chrissavage2300/PIC-High-Powered-LED-Lamp/README.md

# PIC-High-Powered-LED-Lamp
A high power RGBW LED Lamp that uses 18650 batteries and a remote RF signal.
