chrissavage2300/PIC-High-Powered-LED-Lamp/BOM/BOM_RainbowLED_2022_12_28_A.ods

Part | Value | Device | Package | Description | Mouser PN
C1 | 390uF, 20SVPF390M | 20SVPF390M | CAP_20SVPF390M | Check availability | 667-20SVPF390M (https://www.mouser.com/ProductDetail/667-20SVPF390M) | $2.10
C2 | 680 pF | CAP0805 | 805 | Capacitor | GCJ219R72A681KA01D | $0.25
C3 | 15 nF | CAP0805 | 805 | Capacitor | 81-GRM21R72A153KA01L (https://www.mouser.com/ProductDetail/81-GRM21R72A153KA01L) | $0.08
C4 | 220uF, APXF6R3ARA221MF61G | CPOL-USUD-5X5,8 | UD-5X5,8_NICHICON | POLARIZED CAPACITOR, American symbol | 661-APXF6R3RA221MF61 (https://www.mouser.com/ProductDetail/661-APXF6R3RA221MF61) | $0.79
C5 | 100nF | CAP0805 | 805 | Capacitor | 81-GRM21BR72A104KA4K (https://www.mouser.com/ProductDetail/81-GRM21BR72A104KA4K)
C6 | 10pF | CAP0805 | 805 | Capacitor | 603-CC805JRNPO9BN100 (https://www.mouser.com/ProductDetail/603-CC805JRNPO9BN100) | $0.04
D1 | SS24-HF | DIODESMA-ALT | SMA-DIODE_ALT | Diode | stock | $0.25
D2 | JE2835_B_G | JE2835_B_G | JE2835_BLUE | Footprint for JE2835 BLUE or GREEN | 941-JE2835ABLN05AN 941-JE2835AGRN02AN 941-JE2835ARDN01AN 941-JE2835BWTH40GAN (https://www.mouser.com/ProductDetail/941-JE2835ABLN05AN) | $0.29
D3 | JE2835_B_G | JE2835_B_G | JE2835_BLUE | Footprint for JE2835 BLUE or GREEN | same | $0.29
D4 | JE2835_B_G | JE2835_B_G | JE2835_BLUE | Footprint for JE2835 BLUE or GREEN | same | $0.29
D5 | JE2835_B_G | JE2835_B_G | JE2835_BLUE | Footprint for JE2835 BLUE or GREEN | same | $0.29
D6 | JE2835_B_G | JE2835_B_G | JE2835_BLUE | Footprint for JE2835 BLUE or GREEN | same | $0.29
D7 | JE2835_B_G | JE2835_B_G | JE2835_BLUE | Footprint for JE2835 BLUE or GREEN | same | $0.29
D8 | JE2835_B_G | JE2835_B_G | JE2835_BLUE | Footprint for JE2835 BLUE or GREEN | same | $0.29
D9 | JE2835_B_G | JE2835_B_G | JE2835_BLUE | Footprint for JE2835 BLUE or GREEN | same | $0.29
D10 | JE2835_B_G | JE2835_B_G | JE2835_BLUE | Footprint for JE2835 BLUE or GREEN | same | $0.29
D11 | JE2835_B_G | JE2835_B_G | JE2835_BLUE | Footprint for JE2835 BLUE or GREEN | same | $0.29
D12 | JE2835_B_G | JE2835_B_G | JE2835_BLUE | Footprint for JE2835 BLUE or GREEN | same | $0.29
D13 | JE2835_B_G | JE2835_B_G | JE2835_BLUE | Footprint for JE2835 BLUE or GREEN | same | $0.29
D14 | JE2835_B_G | JE2835_B_G | JE2835_BLUE | Footprint for JE2835 BLUE or GREEN | same | $0.29
D15 | JE2835_B_G | JE2835_B_G | JE2835_BLUE | Footprint for JE2835 BLUE or GREEN | same | $0.29
D16 | JE2835_B_G | JE2835_B_G | JE2835_BLUE | Footprint for JE2835 BLUE or GREEN | same | $0.29
D17 | JE2835_B_G | JE2835_B_G | JE2835_BLUE | Footprint for JE2835 BLUE or GREEN | same | $0.29
D18 | JE2835_B_G | JE2835_B_G | JE2835_BLUE | Footprint for JE2835 BLUE or GREEN | same | $0.29
D19 | JE2835_B_G | JE2835_B_G | JE2835_BLUE | Footprint for JE2835 BLUE or GREEN | same | $0.29
D20 | JE2835_B_G | JE2835_B_G | JE2835_BLUE | Footprint for JE2835 BLUE or GREEN | same | $0.29
D21 | JE2835_B_G | JE2835_B_G | JE2835_BLUE | Footprint for JE2835 BLUE or GREEN | same | $0.29
IC1 | PIC16F1575 | PIC16F1503-I/SL | SOIC14_SL |  | PIC16F17126-I/SL | $1.19
IC2 | NCR421ZX | NCR421ZX | SOT223 |  | 771-NCR420ZX (https://www.mouser.com/ProductDetail/771-NCR420ZX) | $0.49
IC3 | NCR421ZX | NCR421ZX | SOT223 |  | 771-NCR420ZX (https://www.mouser.com/ProductDetail/771-NCR420ZX) | $0.49
IC4 | NCR421ZX | NCR421ZX | SOT223 |  | 771-NCR420ZX (https://www.mouser.com/ProductDetail/771-NCR420ZX) | $0.49
IC5 | NCR421ZX | NCR421ZX | SOT223 |  | 771-NCR420ZX (https://www.mouser.com/ProductDetail/771-NCR420ZX) | $0.49
IC6 | NCR421ZX | NCR421ZX | SOT223 |  | 771-NCR420ZX (https://www.mouser.com/ProductDetail/771-NCR420ZX) | $0.49
IC7 | LM3478MA/NOPB | LM3478MA/NOPB | M08A |  | 926-LM3478MAX/NOPB (https://www.mouser.com/ProductDetail/926-LM3478MAX-NOPB) | $2.73
JP1 |  | M05LOCK | 1X05_LOCK | Header 5 | stock
JP2 | M02LOCK_LONGPADS | M02LOCK_LONGPADS | 1X02_LOCK_LONGPADS | Standard 2-pin 0.1 | stock
JP5 | M02LOCK | M02LOCK | 1X02_LOCK | Standard 2-pin 0.1 | stock
L1 | SRR1280-4R7Y | SRR1260-100M | IND_BOURNS_SRR1260 |  | 652-SRR1280-4R7Y | $1.29
Q1 | CSD17308Q3 | CSD17308Q3 | TRANS_CSD17308Q3 | Check availability | 595-CSD17308Q3 (https://www.mouser.com/ProductDetail/595-CSD17308Q3) | $1.00
R1 | 5.1 | RESISTOR1206 | 1206 | Resistor | RC1206FR-075R1L (https://www.mouser.com/ProductDetail/YAGEO/RC1206FR-075R1L) | $0.13
R2 | 5.1 | RESISTOR1206 | 1206 | Resistor | RC1206FR-075R1L (https://www.mouser.com/ProductDetail/YAGEO/RC1206FR-075R1L) | $0.13
R3 | 5.1 | RESISTOR1206 | 1206 | Resistor | RC1206FR-075R1L (https://www.mouser.com/ProductDetail/YAGEO/RC1206FR-075R1L) | $0.13
R4 | 5.1 | RESISTOR1206 | 1206 | Resistor | RC1206FR-075R1L (https://www.mouser.com/ProductDetail/YAGEO/RC1206FR-075R1L) | $0.13
R5 | 5.1 | RESISTOR1206 | 1206 | Resistor | RC1206FR-075R1L (https://www.mouser.com/ProductDetail/YAGEO/RC1206FR-075R1L) | $0.13
R6 | 12mOhm | RESISTOR0805-RES | 805 | Resistor | 71-WFC0805R0120FE66 (https://www.mouser.com/ProductDetail/71-WFC0805R0120FE66) | $0.29
R7 | 100 | RESISTOR0805-RES | 805 | Resistor | 603-AC0805FR-7W100RL (https://www.mouser.com/ProductDetail/603-AC0805FR-7W100RL) | $0.07
R8 | 26.7k | RESISTOR0805-RES | 805 | Resistor | RC0805FR-0726K7L (https://www.mouser.com/ProductDetail/YAGEO/RC0805FR-0726K7L?qs=sGAEpiMZZMvdGkrng054t8AJgcdMkx7xRSnpU5yS1Rk%3D) | $0.07
R9 | 6.65k | RESISTOR0805-RES | 805 | Resistor | RC0805FR-076K65L (https://www.mouser.com/ProductDetail/YAGEO/RC0805FR-076K65L?qs=sGAEpiMZZMvdGkrng054t8AJgcdMkx7xZsGTMqJ6kBU%3D) | $0.10
R10 | 9.53k | RESISTOR0805-RES | 805 | Resistor | RC0805FR-079K53L (https://www.mouser.com/ProductDetail/YAGEO/RC0805FR-079K53L) | $0.10
R11 | 976 | RESISTOR0805-RES | 805 | Resistor | RC0805FR-07976RL (https://www.mouser.com/ProductDetail/YAGEO/RC0805FR-07976RL?qs=sGAEpiMZZMvdGkrng054tzB9oPOc3T13uaiO4Rmyq9g%3D) | $0.10
R12 | 21k | RESISTOR0805-RES | 805 | Resistor | RT0805FRE0721KL (https://www.mouser.com/ProductDetail/YAGEO/RT0805FRE0721KL) | $0.10
R13 | 20k | RESISTOR0805-RES | 805 | Resistor | RT0805FRE0720KL (https://www.mouser.com/ProductDetail/YAGEO/RT0805FRE0720KL?qs=sGAEpiMZZMvdGkrng054t8AJgcdMkx7x8Mi6g3ypq4o%3D) | $0.10
U$1 | C2847244/YUANR4A | C2847244/YUANR4A | C2847244/R4A | Feng Niao RF C2847244 Yuan R4A small, red, rectangular module with built in antenna. With sleep pin. | stock
 |  |  |  |  |  | total
 |  |  |  |  |  | $19.55
