chrissavage2300/PIC-High-Powered-LED-Lamp/schematics/WBDesign51.pdf

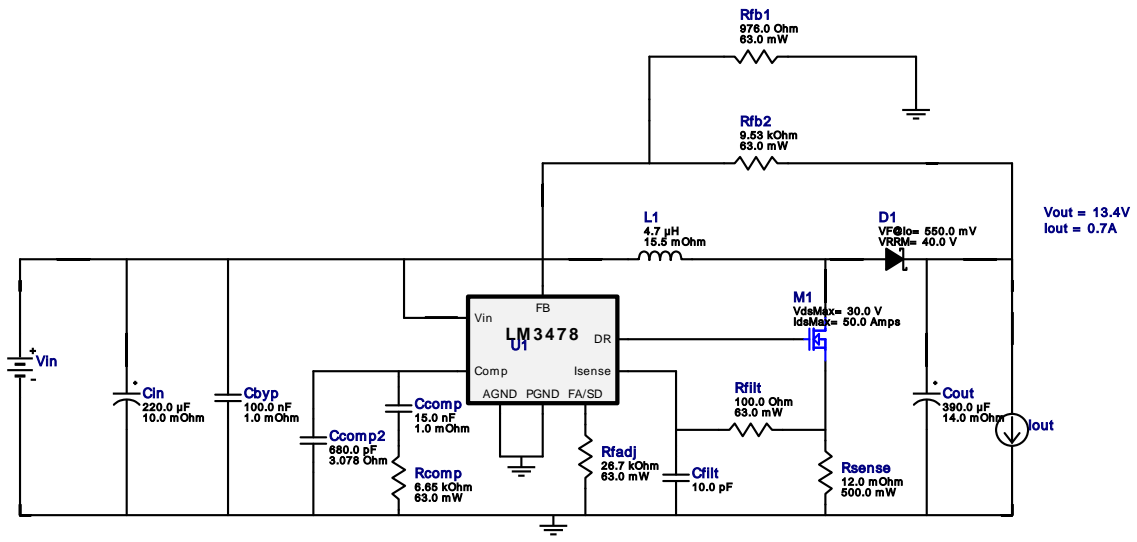
[picture p1: figure]
Rfadj 26.7 kOhm 63.0 m W; Com p; Isense; AGND PGND; Vin; Rcom p 6.65 kOhm 63.0 m W; Vout = 13.4V Iout = 0.7A D1 VF@Io= 550.0 m V VRRM= 40.0 V; Cin 220.0 µF 10.0 m Ohm; Cfilt 10.0 pF; Ccom p 15.0 nF 1.0 m Ohm; L1 4.7 µH 15.5 m Ohm; Rfilt 100.0 Ohm 63.0 m W; Ccom p2 680.0 pF 3.078 Ohm; Cout 390.0 µF 14.0 m Ohm; Cbyp 100.0 nF 1.0 m Ohm; M1 VdsMax= 30.0 V IdsMax= 50.0 Am ps; Rsense 12.0 m Ohm 500.0 m W; Rfb1 976.0 Ohm 63.0 m W; Rfb2 9.53 kOhm 63.0 m W; Iout

Copyright © 2022, Texas Instruments Incorporated | 1 | ti.com/webench

WEBENCH®
Design Report LM3478MM/NOPB : LM3478MM/NOPB 3V-4.2V to 13.40V @ 0.7A December 23, 2022 13:44:39 GMT-06:00

## WEBENCH ® Design Report

Design : 51 LM3478MM/NOPB
LM3478MM/NOPB 3V-4.2V to 13.40V @ 0.7A

VinMin = 3.0V
VinMax = 4.2V
Vout = 13.4V
Iout = 0.7A

Device = LM3478MM/NOPB
Topology = Boost
Created = 2022-12-23 13:14:08.065 BOM Cost = $3.55
BOM Count = 16
Total Pd = 1.43W
1. With the low turn of voltage of the LM34x8 your power supply may current limit before you reach your working input voltage. If this happens, or to preempt this from happening, you can include a low pass RC filter from input voltage to Vin on the IC. Make sure the rise time on the RC network is slower than your supply's rise time.

## Electrical BOM

Name | Manufacturer | Part Number | Properties | Qty Price | Footprint
Cbyp | MuRata | GRM155R70J104KA01D (http://search.murata.co.jp/Ceramy/PnsearchViewAction.do) Series= X7R | Cap= 100.0 nF ESR= 1.0 mOhm VDC= 6.3 V IRMS= 0.0 A
1 | $0.01
| | | | | 0402 3 mm²
Ccomp | MuRata | GRM155R71C153KA01D (http://search.murata.co.jp/Ceramy/PnsearchViewAction.do) Series= X7R

Cap= 15.0 nF
ESR= 1.0 mOhm
VDC= 16.0 V
IRMS= 0.0 A

1 $0.01
0402 3 mm²
Ccomp2 | TDK | CGA2B2X7R1H681K050BA (https://product.tdk.com/en/search/capacitor/ceramic/mlcc/info?part%5Fno%3DCGA2B2X7R1H681K050BA) Series= X7R

Cap= 680.0 pF
ESR= 3.0778 Ohm
VDC= 50.0 V
IRMS= 257.63 mA

1 $0.01
0402 3 mm²
Cfilt | Yageo | CC0805JRNPO9BN100 (http://www.yageo.com/documents/recent/UPY%2DGP%5FNP0%5F16V%2Dto%2D50V%5F10.pdf) Series= C0G/NP0

Cap= 10.0 pF
VDC= 50.0 V
IRMS= 0.0 A

1 $0.01
0805 7 mm²
Cin | Chemi-Con | APXF6R3ARA221MF61G (http://www.chemi%2Dcon.co.jp/cgi%2Dbin/CAT%5FDB/SEARCH/cat%5Fdb%5Fal.cgi?e%3De%26j%3Dp%26pdfname%3Dpxf) Series= PXF

Cap= 220.0 uF
ESR= 10.0 mOhm
VDC= 6.3 V
IRMS= 3.9 A

1 $0.26

CAPSMT_62_F61 74 mm²
Cout | Panasonic | 20SVPF390M Series= SVPF

Cap= 390.0 uF
ESR= 14.0 mOhm
VDC= 20.0 V
IRMS= 4.95 A

1 $1.11

CAPSMT_62_E12 106 mm²
D1 | Fairchild Semiconductor SS24FL | VF@Io= 550.0 mV VRRM= 40.0 V
1 | $0.09
SOD-123F 12 mm²

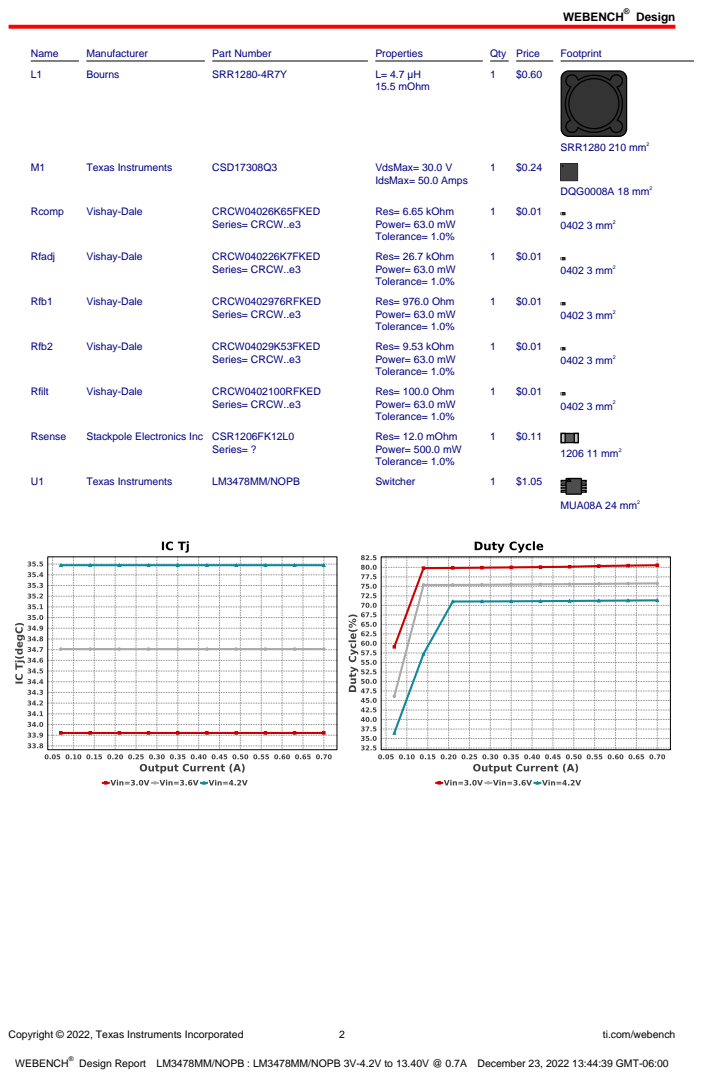
[picture p2: page 2]
Design; Copyright © 2022, Texas Instruments Incorporated; ti.com/webench; Name; Manufacturer; Part Number; Properties; Qty Price; Footprint; Bourns; SRR1280-4R7Y; 15.5 mOhm; SRR1280 210 mm²; Texas Instruments; CSD17308Q3; VdsMax= 30.0 V; IdsMax= 50.0 Amps; DQG0008A 18 mm²; Rcomp; Vishay-Dale; CRCW04026K65FKED; Series= CRCW..e3; Res= 6.65 kOhm Power= 63.0 mW Tolerance= 1.0%; 0402 3 mm²; Rfadj; CRCW040226K7FKED; Res= 26.7 kOhm Power= 63.0 mW Tolerance= 1.0%; Rfb1; CRCW0402976RFKED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

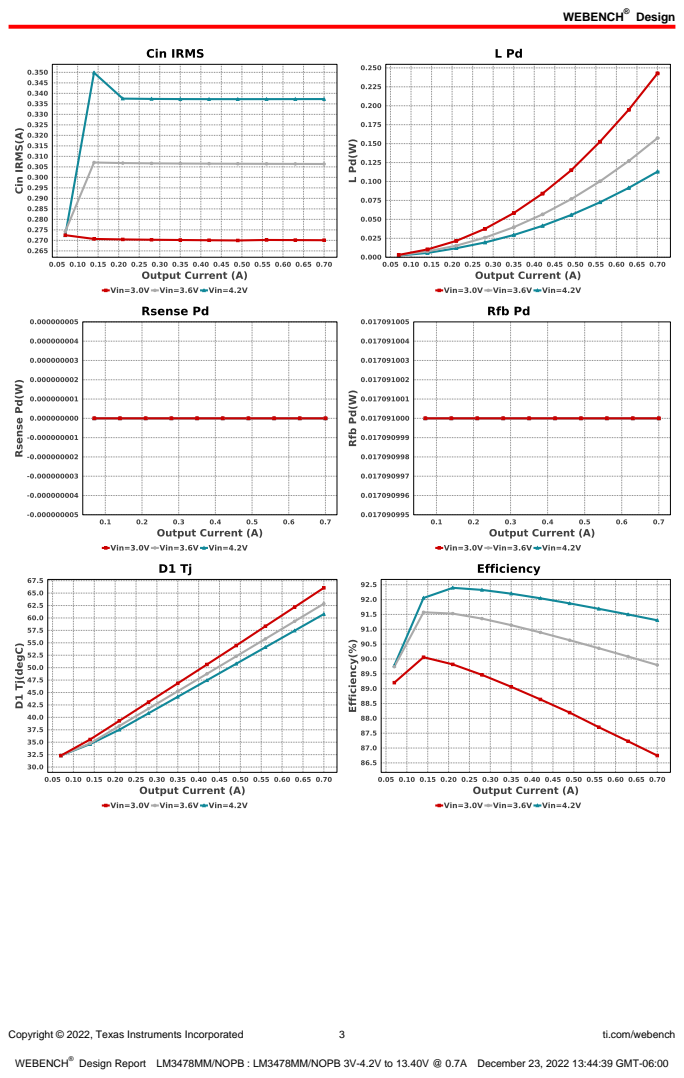
[picture p3: page 3]
Copyright © 2022, Texas Instruments Incorporated; ti.com/webench

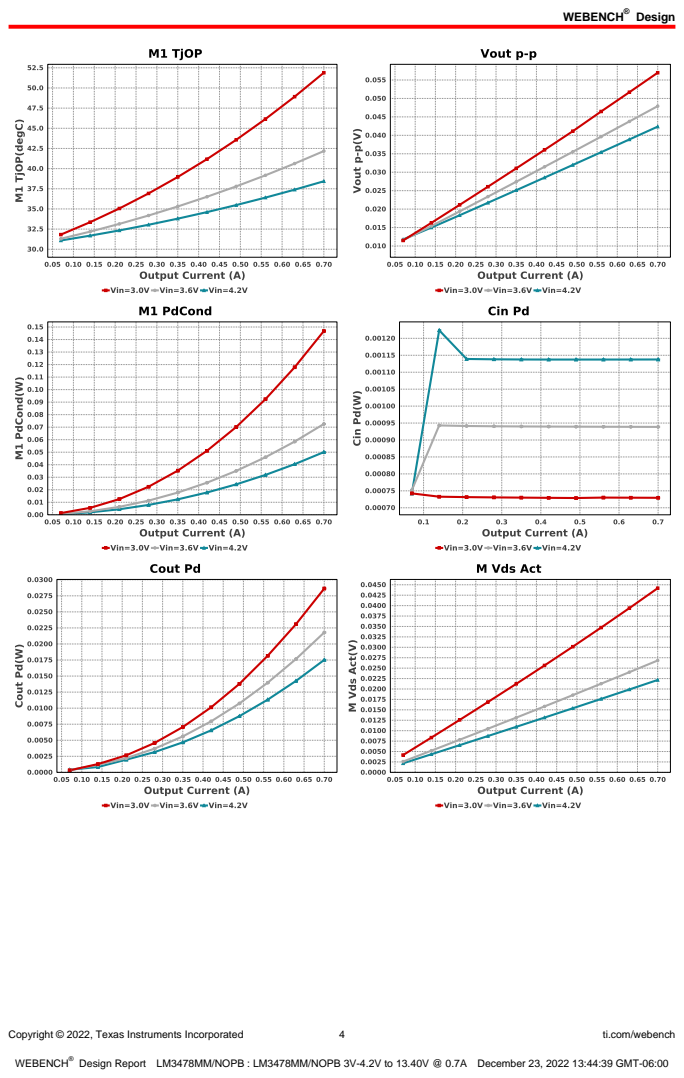
[picture p4: page 4]
Copyright © 2022, Texas Instruments Incorporated; ti.com/webench

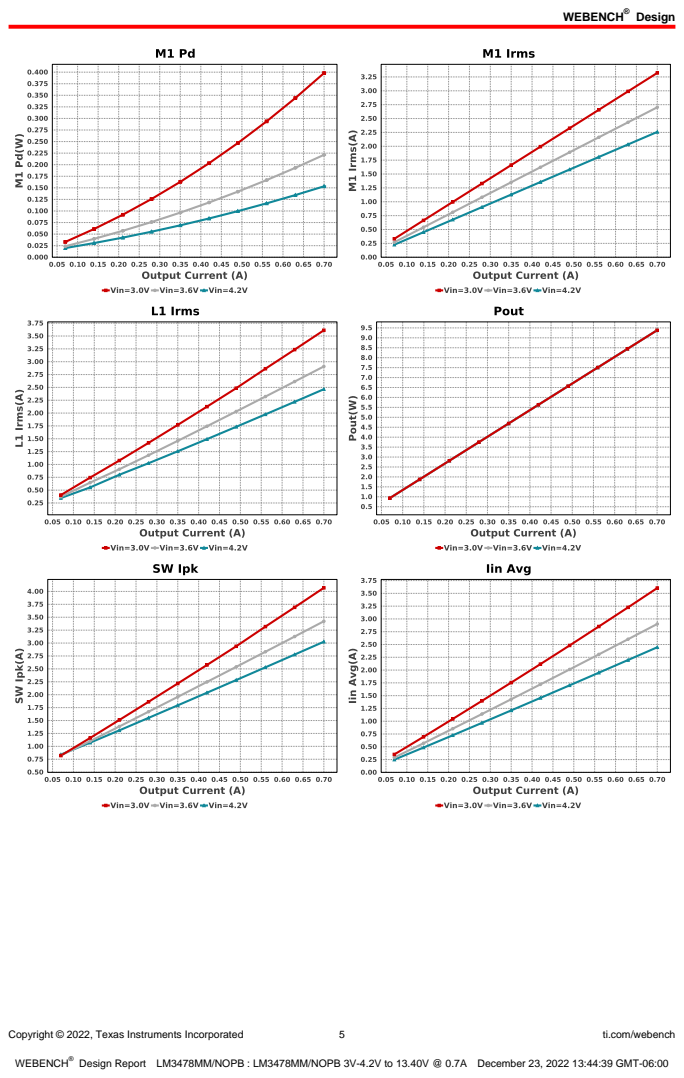
[picture p5: page 5]
Copyright © 2022, Texas Instruments Incorporated; ti.com/webench

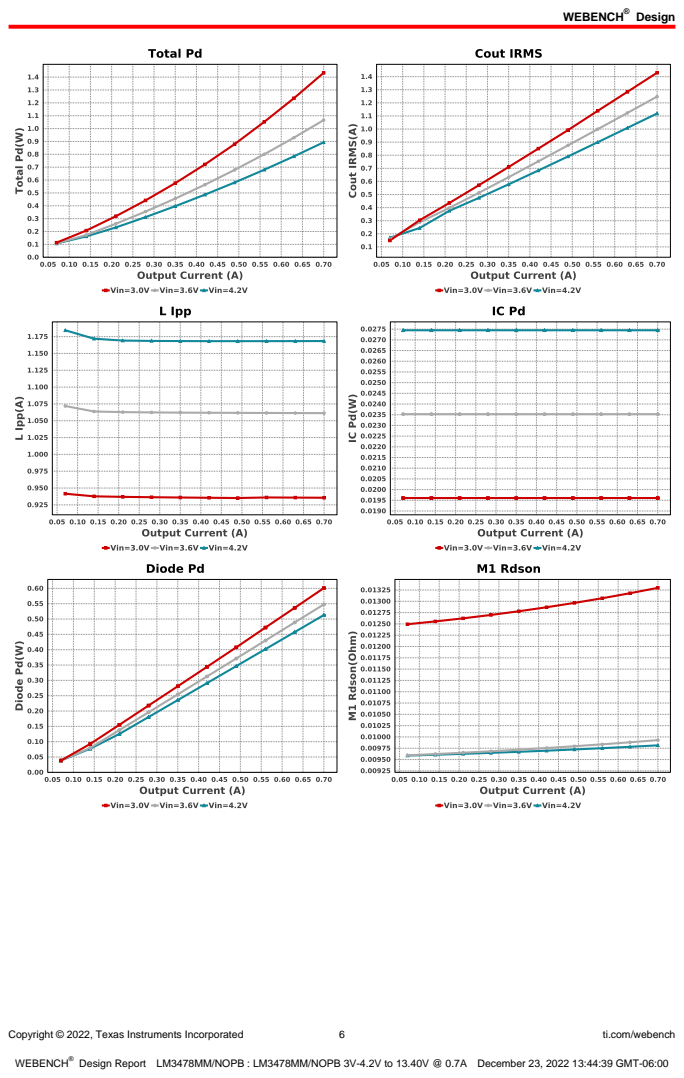
[picture p6: page 6]
Copyright © 2022, Texas Instruments Incorporated; ti.com/webench

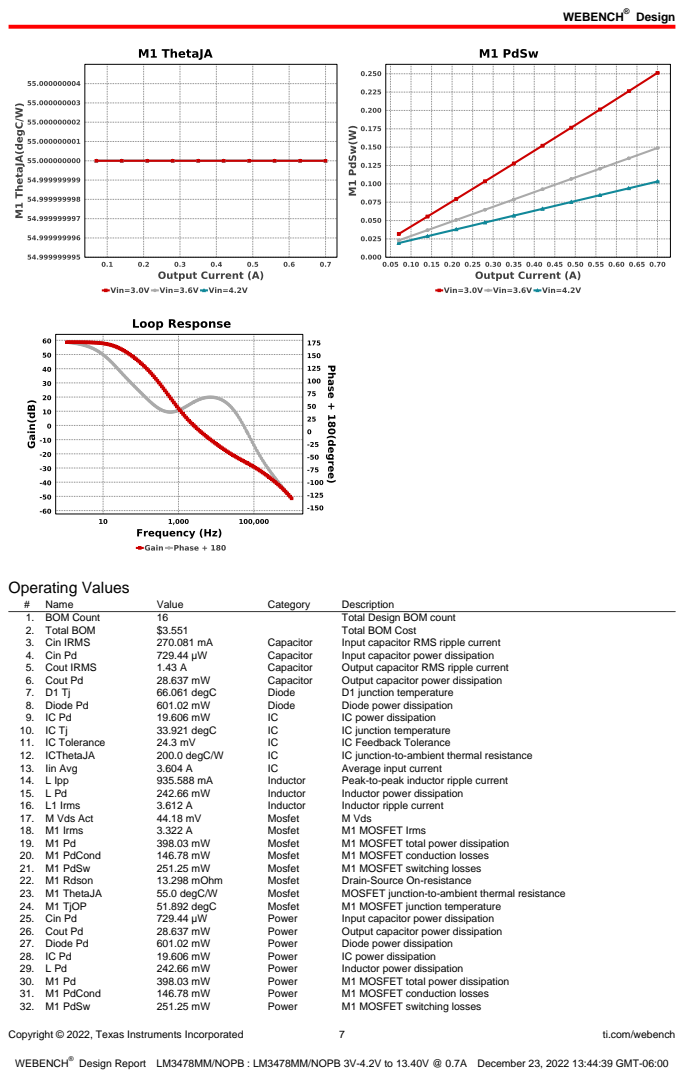
[picture p7: page 7]
Copyright © 2022, Texas Instruments Incorporated; ti.com/webench; Operating Values; Name; Value; Category; Description; 1. BOM Count; Total Design BOM count; 2. Total BOM; Total BOM Cost; 3. Cin IRMS; Capacitor; Input capacitor RMS ripple current; 4. Cin Pd; Input capacitor power dissipation; 5. Cout IRMS; Output capacitor RMS ripple current; 6. Cout Pd; Output capacitor power dissipation; 66.061 degC; Diode; D1 junction temperature; 8. Diode Pd; Diode power dissipation; IC power dissipation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

Copyright © 2022, Texas Instruments Incorporated | 8 | ti.com/webench
# | Name | Value | Category | Description

33. Rfb Pd | 17.091 mW | Power | Rfb Power Dissipation
34. Rsense Pd | 0.0 W | Power | LED Current Rsns Power Dissipation
35. Total Pd | 1.433 W | Power | Total Power Dissipation
36. Rfb Pd | 17.091 mW | Resistor | Rfb Power Dissipation
37. Rsense Pd | 0.0 W | Resistor | LED Current Rsns Power Dissipation
38. Cross Freq | 1.902 kHz | System
| | | Information | Bode plot crossover frequency
39. Duty Cycle | 80.566 % | System
| | | Information | Duty cycle
40. Efficiency | 86.746 % | System
| | | Information | Steady state efficiency
41. FootPrint | 486.0 mm² | System
| | | Information | Total Foot Print Area of BOM components
42. Frequency | 541.734 kHz | System
| | | Information | Switching frequency
43. Gain Marg | -23.314 dB | System
| | | Information | Bode Plot Gain Margin
44. Iout | 700.0 mA | System
| | | Information | Iout operating point
45. Low Freq Gain | 55.302 dB | System
| | | Information | Gain at 1Hz
46. Mode | CCM | System
| | | Information | Conduction Mode
47. Phase Marg | 51.26 deg | System
| | | Information | Bode Plot Phase Margin
48. Pout | 9.38 W | System
| | | Information | Total output power
49. SW Ipk | 4.07 A | System
| | | Information | Peak switch current
50. Vin | 3.0 V | System
| | | Information | Vin operating point
51. Vout | 13.4 V | System
| | | Information | Operational Output Voltage
52. Vout Actual | 13.563 V | System
| | | Information | Vout Actual calculated based on selected voltage divider resistors
53. Vout Tolerance | 3.796 % | System
| | | Information | Vout Tolerance based on IC Tolerance (no load) and voltage divider resistors if applicable
54. Vout p-p | 56.975 mV | System
| | | Information | Peak-to-peak output ripple voltage

## Design Inputs

Name | Value | Description
| Iout | | 700.0 m | Maximum Output Current
VinMax | 4.2 | Maximum input voltage
VinMin | 3.0 | Minimum input voltage
Vout | 13.4 | Output Voltage
| base_pn | | LM3478 | Base Product Number
source | DC | Input Source Type
Ta | 30.0 | Ambient temperature


Copyright © 2022, Texas Instruments Incorporated | 9 | ti.com/webench

## Assembly

## Component Testing

Some published data on components in datasheets such as Capacitor ESR and Inductor DC resistance is based on conservative values that will guarantee that the components always exceed the specification. For design purposes it is usually better to work with typical values. Since this data is not always available it is a good practice to measure the Capacitance and ESR values of Cin and Cout, and the inductance and DC resistance of L1 before assembly of the board. Any large discrepancies in values should be electrically simulated in WEBENCH to check for instabilities and thermally simulated in WebTHERM to make sure critical temperatures are not exceeded.

## Soldering Component to Board

If board assembly is done in house it is best to tack down one terminal of a component on the board then solder the other terminal. For surface mount parts with large tabs, such as the DPAK, the tab on the back of the package should be pre-tinned with solder, then tacked into place by one of the pins. To solder the tab town to the board place the iron down on the board while resting against the tab, heating both surfaces simultaneously. Apply light pressure to the top of the plastic case until the solder flows around the part and the part is flush with the PCB. If the solder is not flowing around the board you may need a higher wattage iron (generally 25W to 30W is enough).

## Initial Startup of Circuit

It is best to initially power up the board by setting the input supply voltage to the lowest operating input voltage 3.0V and set the input supply's current limit to zero. With the input supply off connect up the input supply to Vin and GND. Connect a digital volt meter and a load if needed to set the minimum Iout of the design from Vout and GND. Turn on the input supply and slowly turn up the current limit on the input supply. If the voltage starts to rise on the input supply continue increasing the input supply current limit while watching the output voltage. If the current increases on the input supply, but the voltage remains near zero, then there may be a short or a component misplaced on the board. Power down the board and visually inspect for solder bridges and recheck the diode and capacitor polarities. Once the power supply circuit is operational then more extensive testing may include full load testing, transient load and line tests to compare with simulation results.

## Load Testing

The setup is the same as the initial startup, except that an additional digital voltmeter is connected between Vin and GND, a load is connected between Vout and GND and a current meter is connected in series between Vout and the load. The load must be able to handle at least rated output power + 50% ( 7.5 watts for this design). Ideally the load is supplied in the form of a variable load test unit. It can also be done in the form of suitably large power resistors. When using an oscilloscope to measure waveforms on the prototype board, the ground leads of the oscilloscope probes should be as short as possible and the area of the loop formed by the ground lead should be kept to a minimum. This will help reduce ground lead inductance and eliminate EMI noise that is not actually present in the circuit.

## Design Assistance

1. Master key : 1955E47119554D04[v1]
2. LM3478 Product Folder : http://www.ti.com/product/LM3478 : contains the data sheet and other resources.

Copyright © 2022, Texas Instruments Incorporated | 10 | ti.com/webench

Important Notice and Disclaimer

TI provides technical and reliability data (including datasheets), design resources (including reference designs), application or other design advice, web tools, safety information, and other resources AS IS and with all faults, and disclaims all warranties. These resources are intended for skilled developers designing with TI products. You are solely responsible for (1) selecting the appropriate TI products for your application, (2) designing, validating and testing your application, and (3) ensuring your application meets applicable standards, and any other safety, security, or other requirements.

These resources are subject to change without notice. TI grants you permission to use these resources only for development of an application that uses the TI products described in the resource. Other reproduction and display of these resources is prohibited. No license is granted to any other TI intellectual property right or to any third party intellectual property right. TI disclaims responsibility for, and you will fully indemnify TI and its representatives against, any claims, damages, costs, losses, and liabilities arising out of your use of these resources.

Providing these resources does not expand or otherwise alter TI's applicable Terms of Sale or other applicable terms available either on ti.com or provided in conjunction with TI products.
