chrissavage2300/PIC-High-Powered-LED-Lamp/schematics/HP_LED_2023_01_22_A.pdf

# DR 6 FA/SD

# Q1 R⁶

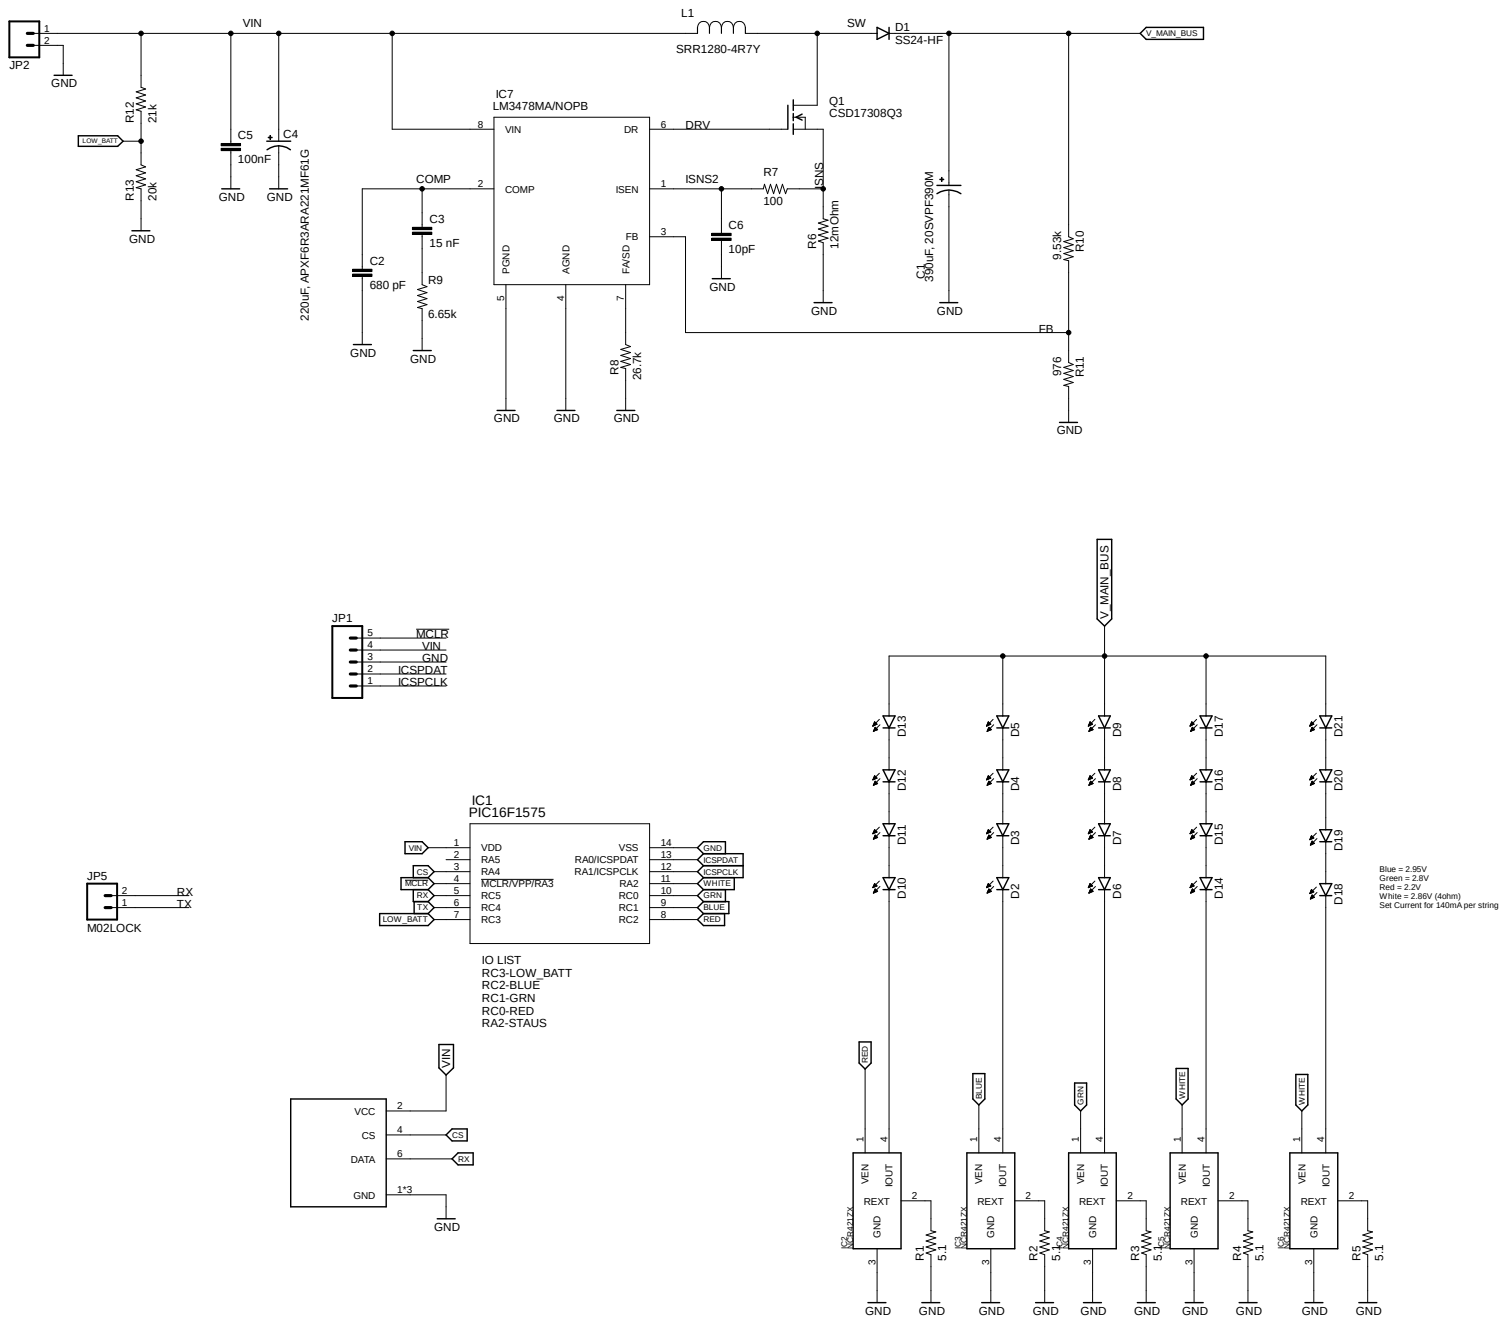
[picture p9: page 1]
