chrissavage2300/PIC-High-Powered-LED-Lamp/schematics/LED_Transmitter_2023_01_22_A.brd

## EAGLE design schematics/LED_Transmitter_2023_01_22_A.brd (2023-01-22)

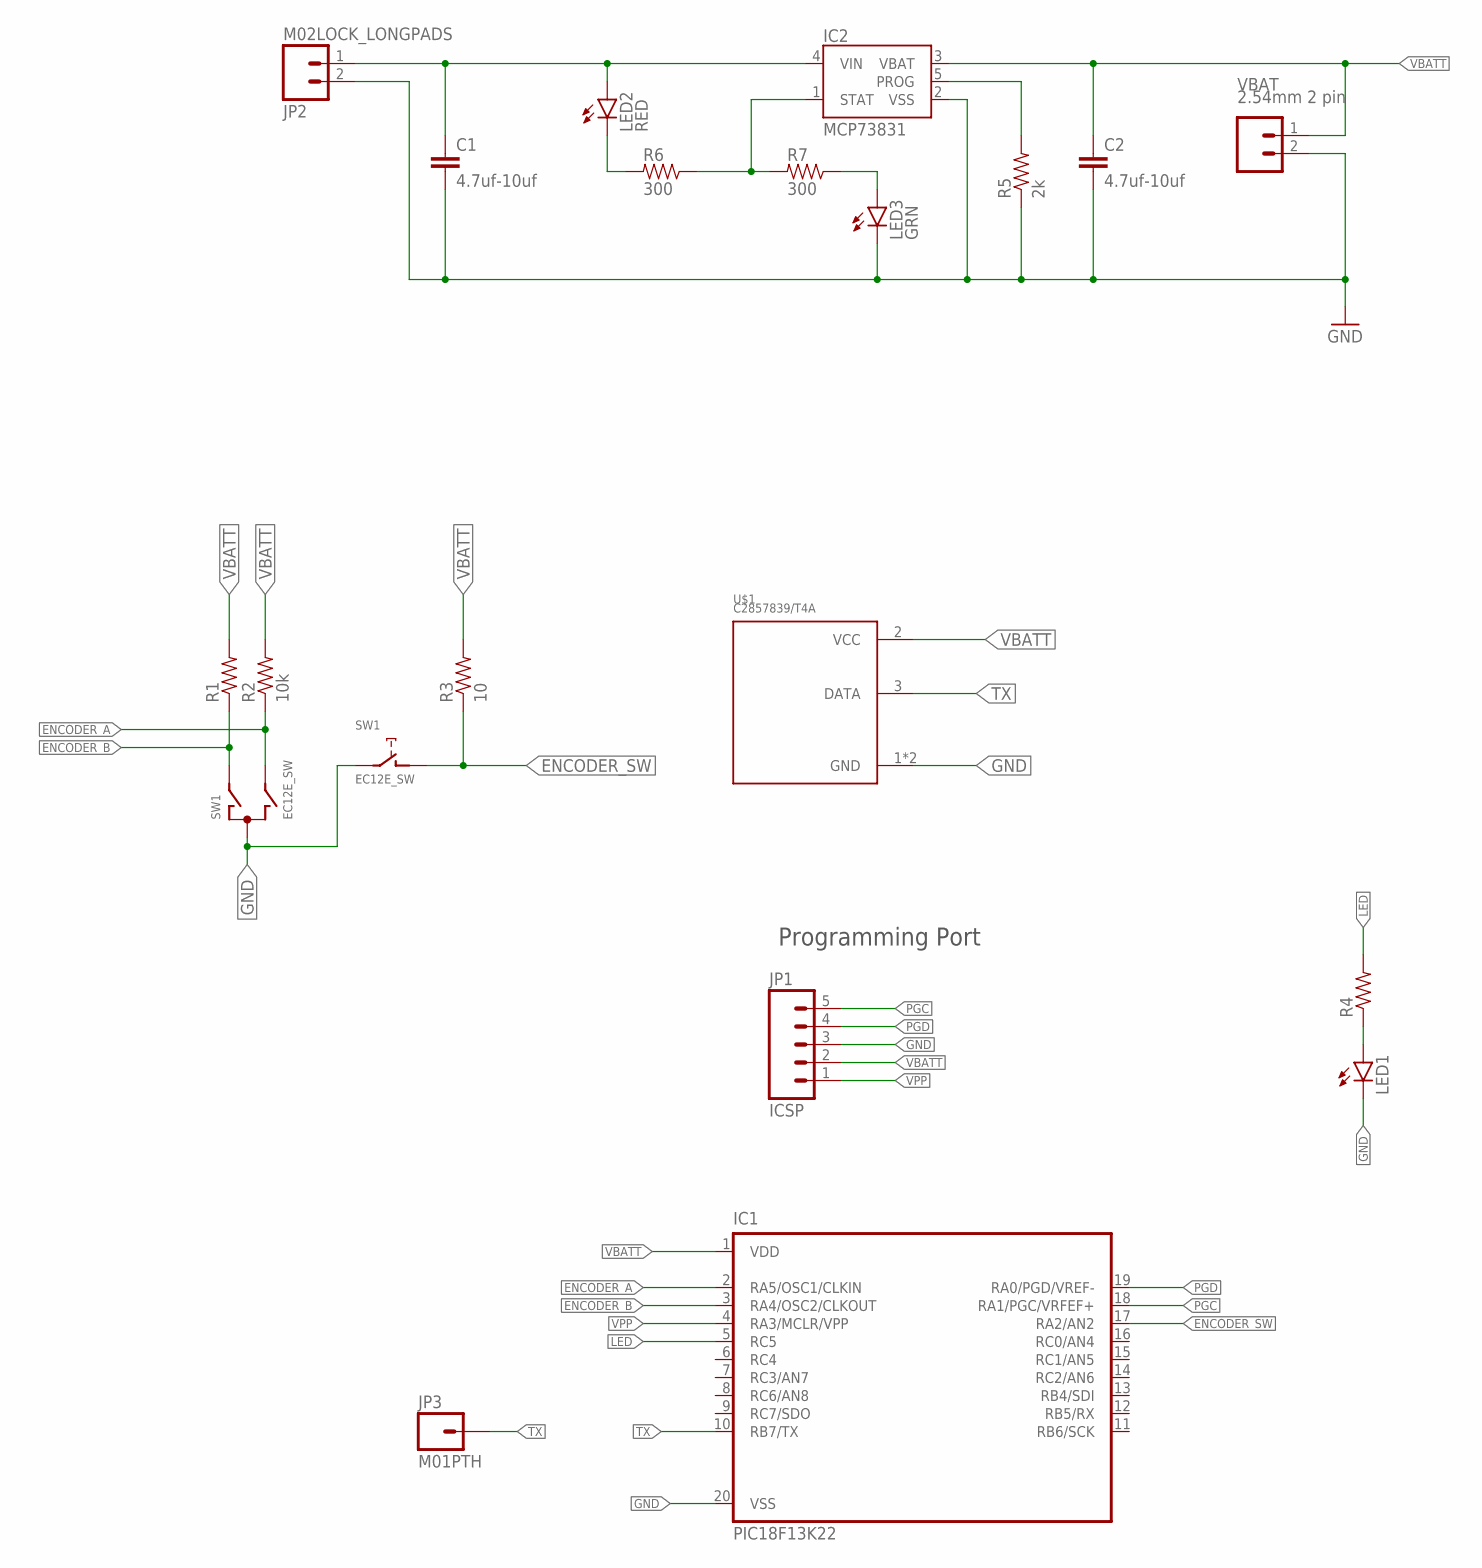
[picture p10: schematic LED_Transmitter_2023_01_22_A.sch]

Parts:
C1, C2: 4.7uf-10uf; 1206
IC1: PIC18F13K22; DIL20
IC2: MCP73831; SOT23-5
JP1: ICSP; 1X05
JP2: M02LOCK_LONGPADS; 1X02_LOCK_LONGPADS
JP3: M01PTH; 1X01
LED1: LED1206; LED-1206
LED2: RED; LED-1206
LED3: GRN; LED-1206
R1, R4: RESISTOR1206; 1206
R2: 10k; 1206
R3: 10; 1206
R5: 2k; 1206
R6, R7: 300; 1206
SW1: EC12E_SW; ALPS_EC12E_SW
U$1: C2857839/T4A; 1X04_LOCK_LONGPADS
VBAT: 2.54mm 2 pin; JST-2-PTH-VERT

Connections:
ENCODER_A: IC1.2 (RA5/OSC1/CLKIN), R2.1, SW1.B
ENCODER_B: IC1.3 (RA4/OSC2/CLKOUT), R1.1, SW1.A
ENCODER_SW: IC1.17 (RA2/AN2), R3.1, SW1.D (1)
GND: C1.2, C2.2, IC1.20 (VSS), IC2.2 (VSS), JP1.3, JP2.2, LED1.C, LED3.C, R5.1, SW1.C, SW1.E (2), U$1.1 (GND), U$1.4 (GND), VBAT.2
LED: IC1.5 (RC5), R4.2
unnamed: LED1.A, R4.1
unnamed: LED2.C, R6.2
unnamed: IC2.1 (STAT), R6.1, R7.2
unnamed: IC2.5 (PROG), R5.2
unnamed: LED3.A, R7.1
PGC: IC1.18 (RA1/PGC/VRFEF+), JP1.5
PGD: IC1.19 (RA0/PGD/VREF-), JP1.4
TX: IC1.10 (RB7/TX), JP3.1, U$1.3 (DATA)
VBATT: C2.1, IC1.1 (VDD), IC2.3 (VBAT), JP1.2, R1.2, R2.2, R3.2, U$1.2 (VCC), VBAT.1
VBUS: C1.1, IC2.4 (VIN), JP2.1, LED2.A
VPP: IC1.4 (RA3/MCLR/VPP), JP1.1

Notes on the sheet:
Programming Port

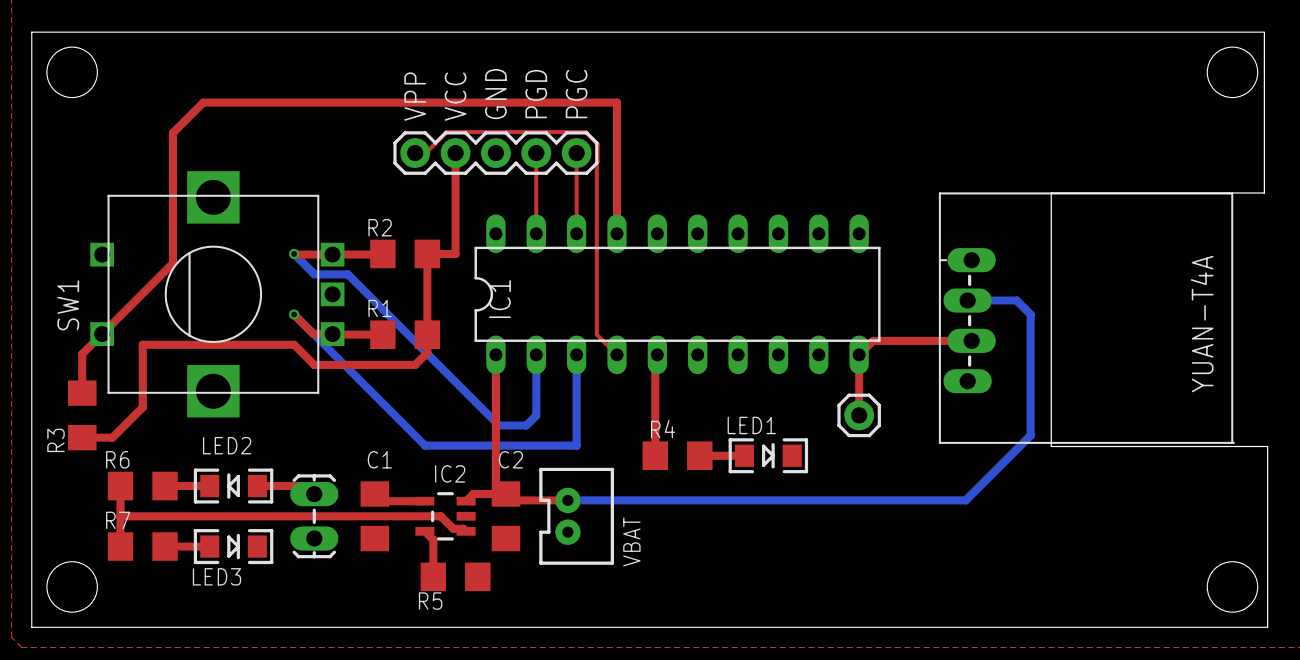
[picture p11: board LED_Transmitter_2023_01_22_A.brd from above]

Board: 2 copper layers, 77.8 x 37.5 mm, 20 parts (0 on the bottom side), 16 nets.
