chrissavage2300/PIC-High-Powered-LED-Lamp/schematics/PIC_HP_LED_2023_01_22_A.brd

## EAGLE design schematics/PIC_HP_LED_2023_01_22_A.brd (2023-01-22)

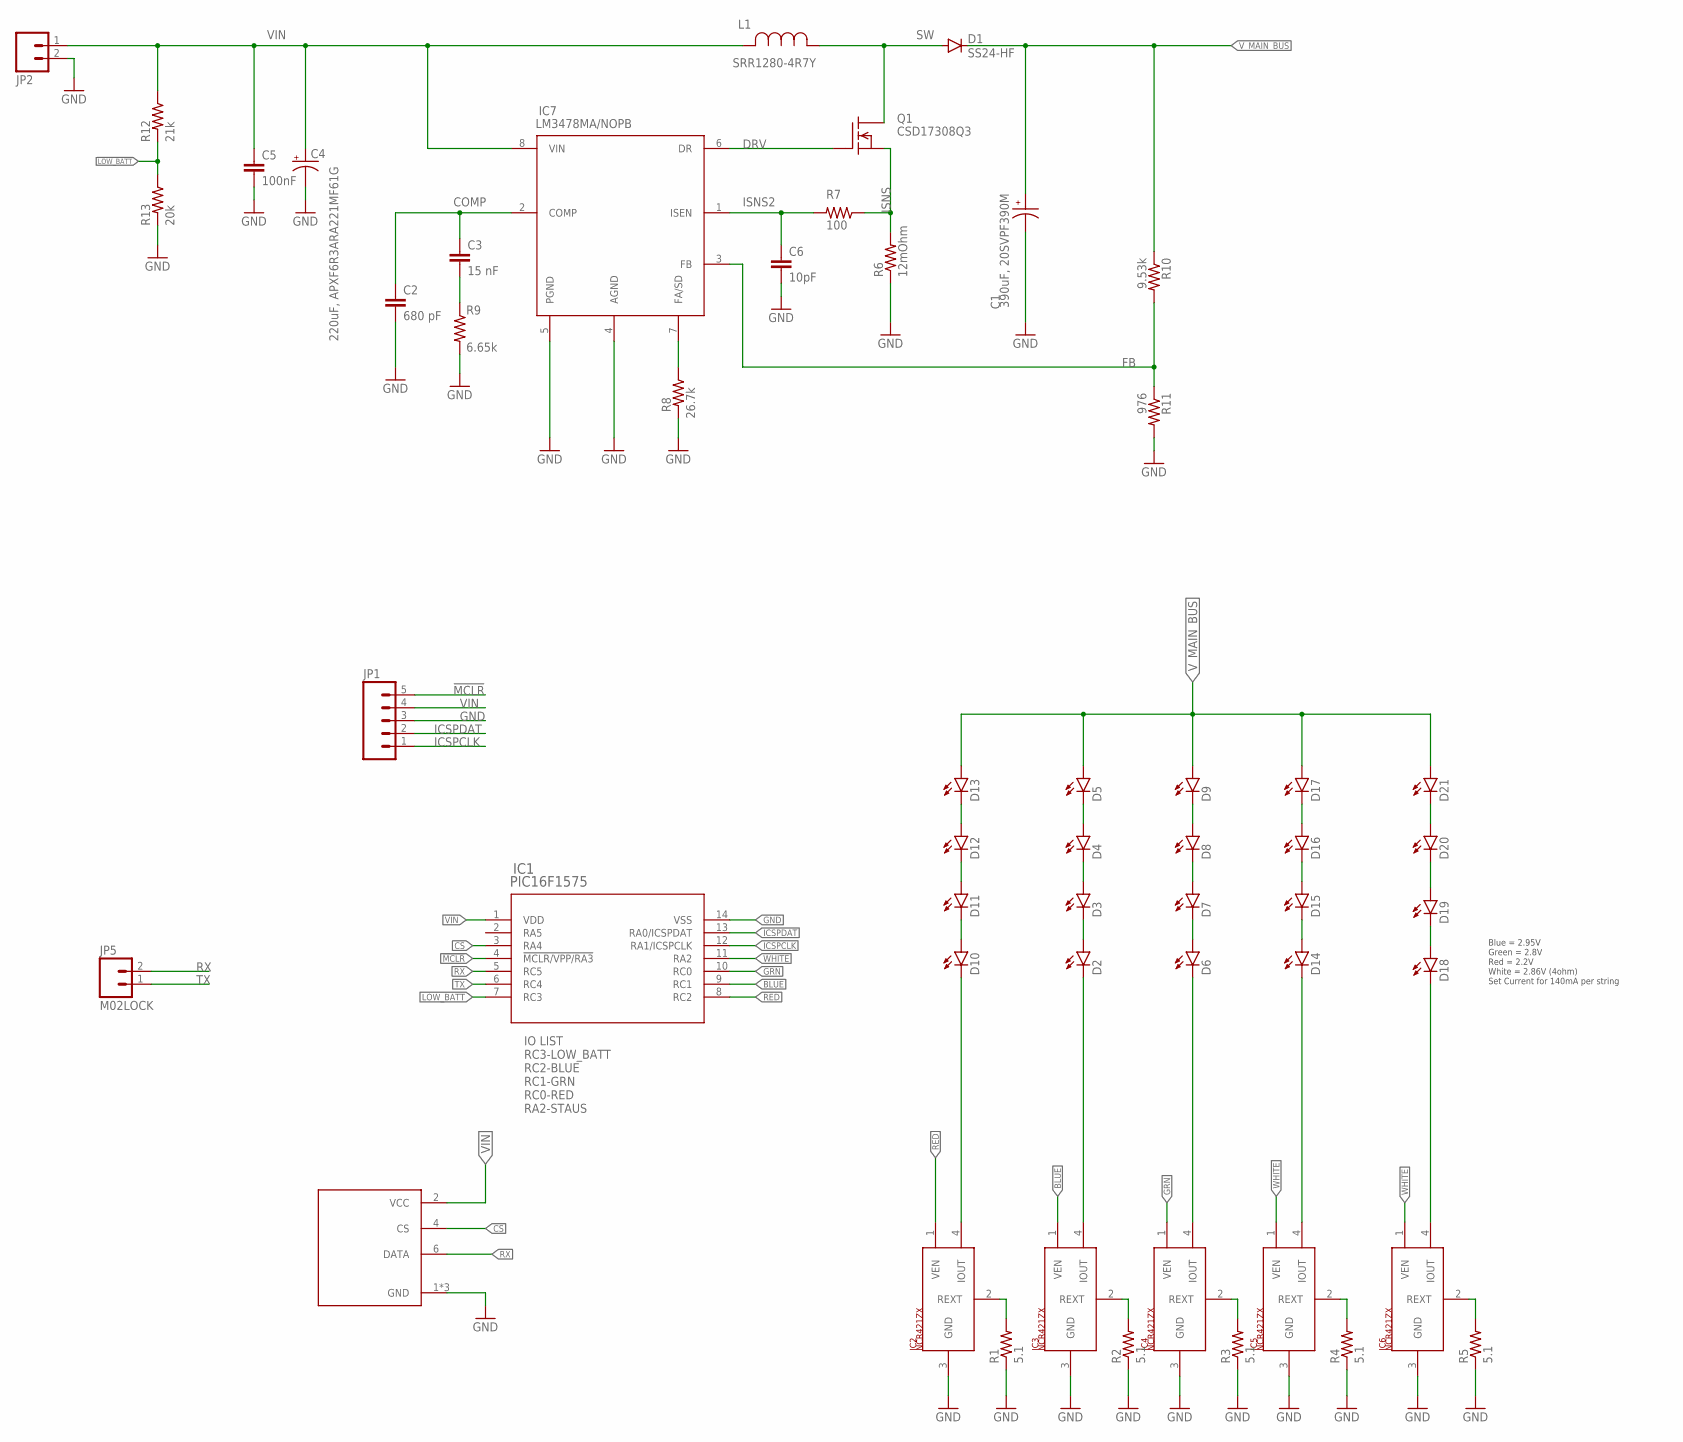
[picture p12: schematic PIC_HP_LED_2023_01_22_A.sch]

Parts:
C1: 390uF, 20SVPF390M; CAP_20SVPF390M
C2: 680 pF; 0805
C3: 15 nF; 0805
C4: 220uF, APXF6R3ARA221MF61G; UD-5X5,8_NICHICON
C5: 100nF; 0805
C6: 10pF; 0805
D1: SS24-HF; SMA-DIODE_ALT
D2, D3, D4, D5, D6, D7, D8, D9, D10, D11, D12, D13, D14, D15, D16, D17, D18, D19, D20, D21: JE2835_B_G; JE2835_BLUE
IC1: PIC16F1575; SOIC14_SL
IC2, IC3, IC4, IC5, IC6: NCR421ZX; SOT223
IC7: LM3478MA/NOPB; M08A
JP1: M05LOCK; 1X05_LOCK
JP2: M02LOCK_LONGPADS; 1X02_LOCK_LONGPADS
JP5: M02LOCK; 1X02_LOCK
L1: SRR1280-4R7Y; IND_BOURNS_SRR1260
Q1: CSD17308Q3; TRANS_CSD17308Q3
R1, R2, R3, R4, R5: 5.1; 1206
R6: 12mOhm; 0805
R7: 100; 0805
R8: 26.7k; 0805
R9: 6.65k; 0805
R10: 9.53k; 0805
R11: 976; 0805
R12: 21k; 0805
R13: 20k; 0805
U$1: C2847244/YUANR4A; C2847244/R4A

Connections:
!MCLR: IC1.4 (!MCLR/VPP/RA3), JP1.5
BLUE: IC1.9 (RC1), IC3.1 (VEN)
BLUE-: D2.C, IC3.4 (IOUT)
COMP: C2.1, C3.1, IC7.2 (COMP)
CS: IC1.3 (RA4), U$1.4 (CS)
DRV: IC7.6 (DR), Q1.G
FB: IC7.3 (FB), R10.2, R11.1
GND: C1.2, C2.2, C4.-, C5.2, C6.2, IC1.14 (VSS), IC2.3 (GND), IC3.3 (GND), IC4.3 (GND), IC5.3 (GND), IC6.3 (GND), IC7.4 (AGND), IC7.5 (PGND), JP1.3, JP2.2, R1.1, R2.1, R3.1, R4.1, R5.1, R6.1, R8.2, R9.2, R11.2, R13.2, U$1.1 (GND), U$1.3 (GND), U$1.5 (GND)
GRN: IC1.10 (RC0), IC4.1 (VEN)
GRN-: D6.C, IC4.4 (IOUT)
ICSPCLK: IC1.12 (RA1/ICSPCLK), JP1.1
ICSPDAT: IC1.13 (RA0/ICSPDAT), JP1.2
ISNS: Q1.S1 (S), Q1.S2 (S), Q1.S3 (S), R6.2, R7.1
ISNS2: C6.1, IC7.1 (ISEN), R7.2
LOW_BATT: IC1.7 (RC3), R12.2, R13.1
unnamed: D10.A, D11.C
unnamed: D6.A, D7.C
unnamed: D2.A, D3.C
unnamed: D3.A, D4.C
unnamed: D7.A, D8.C
unnamed: D11.A, D12.C
unnamed: D12.A, D13.C
unnamed: D8.A, D9.C
unnamed: D4.A, D5.C
unnamed: IC2.2 (REXT), R1.2
unnamed: IC3.2 (REXT), R2.2
unnamed: IC4.2 (REXT), R3.2
unnamed: IC5.2 (REXT), R4.2
unnamed: D14.A, D15.C
unnamed: D15.A, D16.C
unnamed: D16.A, D17.C
unnamed: D14.C, IC5.4 (IOUT)
unnamed: D18.A, D19.C
unnamed: D19.A, D20.C
unnamed: D20.A, D21.C
unnamed: D18.C, IC6.4 (IOUT)
unnamed: IC6.2 (REXT), R5.2
unnamed: IC7.7 (FA/SD), R8.1
unnamed: C3.2, R9.1
RED: IC1.8 (RC2), IC2.1 (VEN)
RED-: D10.C, IC2.4 (IOUT)
RX: IC1.5 (RC5), JP5.2, U$1.6 (DATA)
SW: D1.A, L1.1, Q1.5-8 (D)
TX: IC1.6 (RC4), JP5.1
VIN: C4.+, C5.1, IC1.1 (VDD), IC7.8 (VIN), JP1.4, JP2.1, L1.2, R12.1, U$1.2 (VCC)
V_MAIN_BUS: C1.1, D1.C, D5.A, D9.A, D13.A, D17.A, D21.A, R10.1
WHITE: IC1.11 (RA2), IC5.1 (VEN), IC6.1 (VEN)

Notes on the sheet:
IO LIST RC3-LOW_BATT RC2-BLUE RC1-GRN RC0-RED RA2-STAUS
Blue = 2.95V Green = 2.8V Red = 2.2V White = 2.86V (4ohm) Set Current for 140mA per string

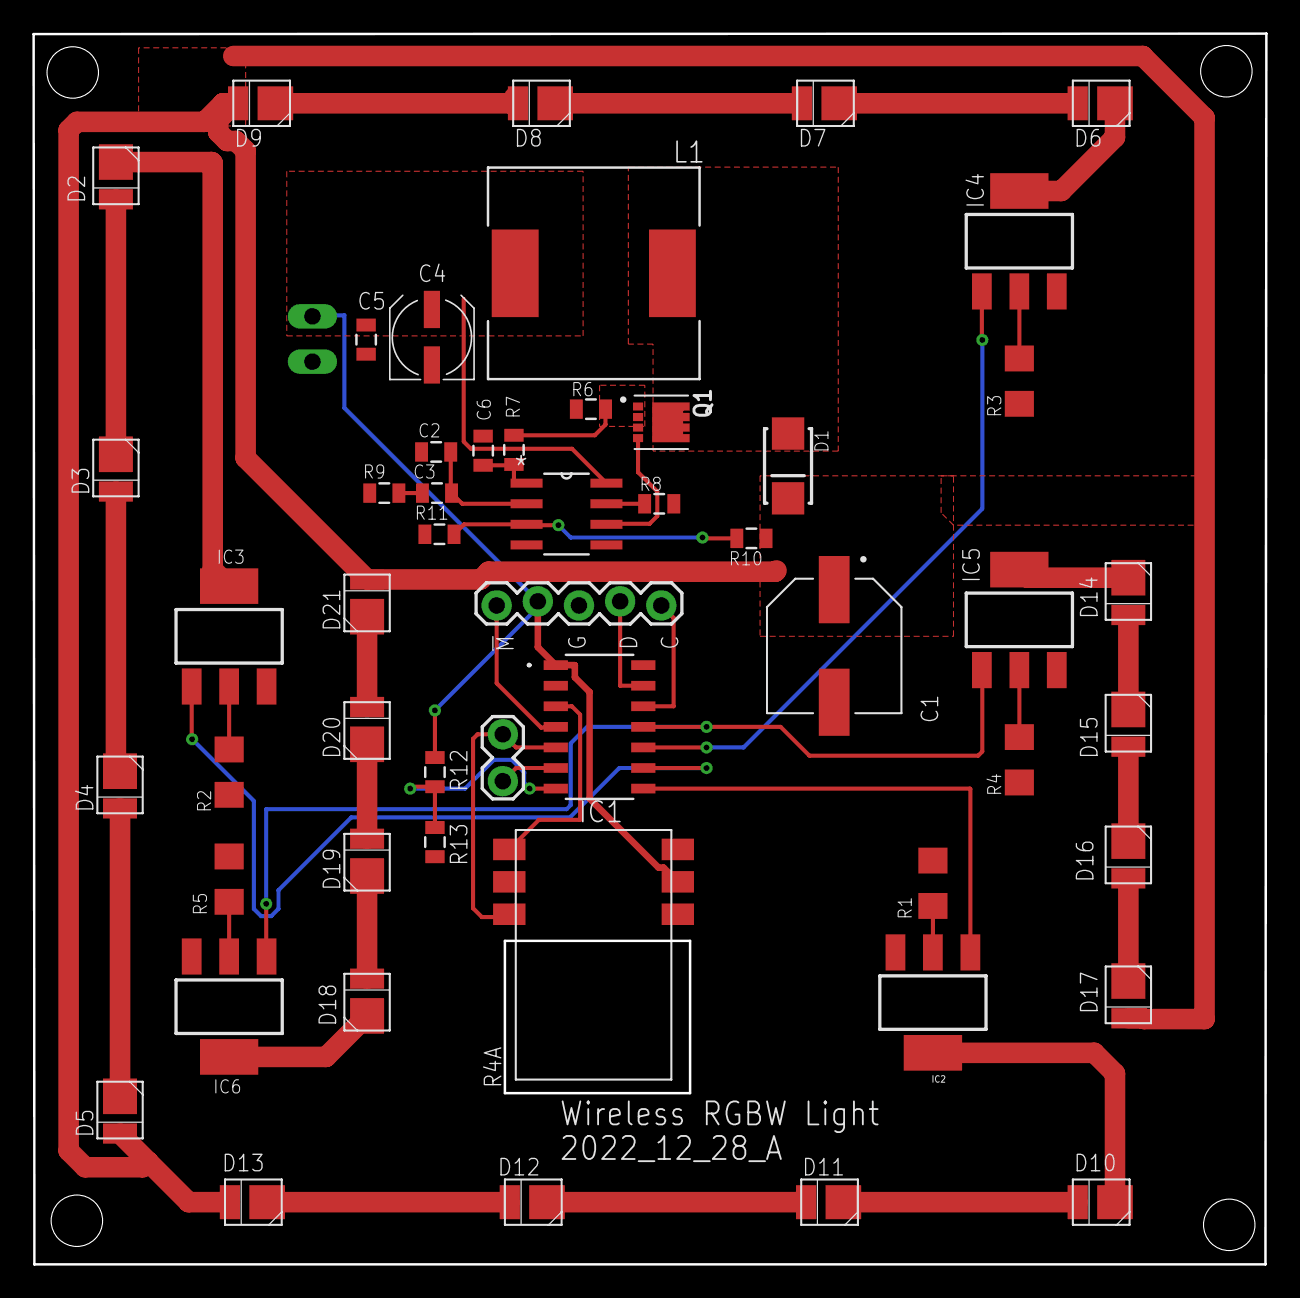
[picture p13: board PIC_HP_LED_2023_01_22_A.brd from above]

Board: 2 copper layers, 76.1 x 76.0 mm, 53 parts (1 on the bottom side), 47 nets.
