chrissavage2300/PIC-High-Powered-LED-Lamp/(notices)

Notices in the files:
parts and their libraries:
SparkFun-Connectors: Licensing: Creative Commons ShareAlike 4.0 International - https://creativecommons.org/licenses/by-sa/4.0
COPYRIGHT: Copyright (C) 2022 Ultra Librarian. All rights reserved.
COPYRIGHT: Copyright (C) 2021 Ultra Librarian. All rights reserved.
